manasdas17/LoRa-SmartGarbageCollection/Documentation/Presentation/Smart-Garbage-Collection.pptx

## Smart Garbage Collection

CS 684 - Embedded Systems
Spring 2018

Group members
Manas (163236001)
Sambit (163230013)
Emmey (163230003)

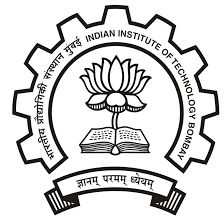
[picture p1: figure]

## Problem Statement

Brief description of the goal of project :
- Placing Sensor based static waste collection garbage bins
- Making it IoT enabled by LoRaWan protocol
- Geo-tagging of bins
- Build an application with an integration to Google Map as background layer
- Indicating different levels of waste to the user

## Requirements :- Hardware

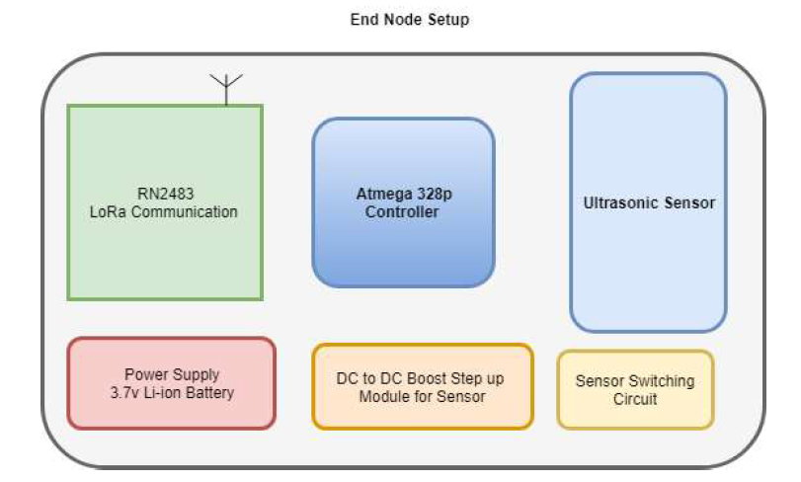
[picture p2: figure]

Software

## Requirements :- Software

Web application having (specific features)
- Waste Level Indicator
- Google Map indication of location of bins
- Framework : javascript, node.js

## Challenges :

- Packaging the hardware in a single PCB
- Making the setup as compact as possible
- Low power design
- Coming up with a web application with specific features
- Problem with Ultrasonic sensor calibration.

## Deliverables

Hardware
- Two no. of sensor nodes with gateway on Rpi
Software
- Web appliation with facility of level indicator of waste and location specifier

## Test Strategies

1. Hardware testing with sensor
2. LoRaWan communication with the sensor node
3. Testing of the sensor node and gateway communication with python script
4. Testing of the whole setup with node, gateway and web application.

## Timeline

1. Circuit Diagram & PCB Design on KiCad (22nd March)
2. Sensor node Setup (29th March)
3. Web application (5th April)
4. Testing & Final delivary(12th April)

## Deliverables-I:Schematic & PCB

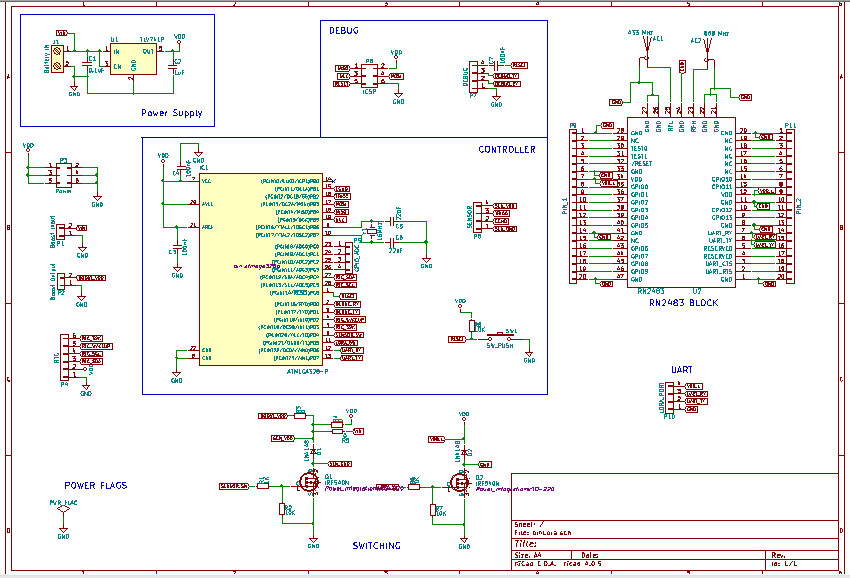
[picture p3: figure]

## Deliverables-I:Schematic & PCB

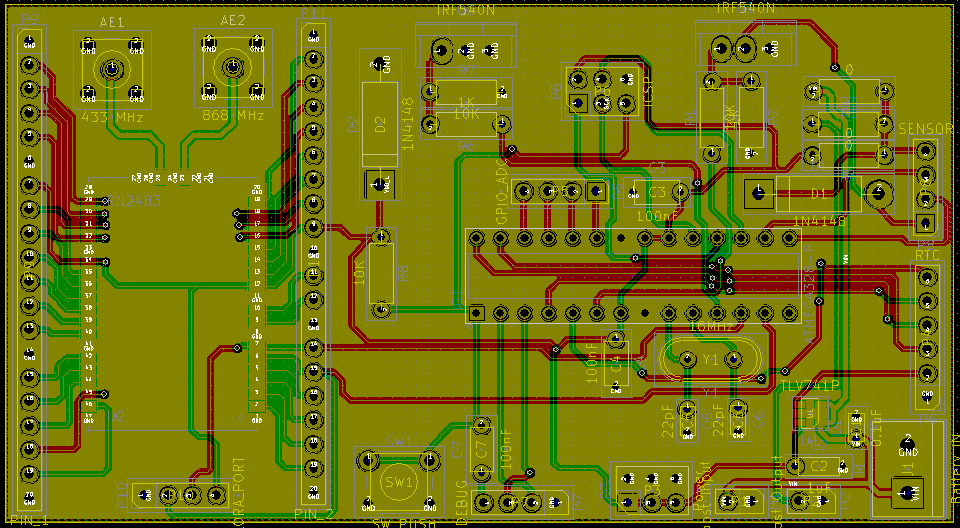
[picture p4: figure]

## Deliverables-II: Node setup

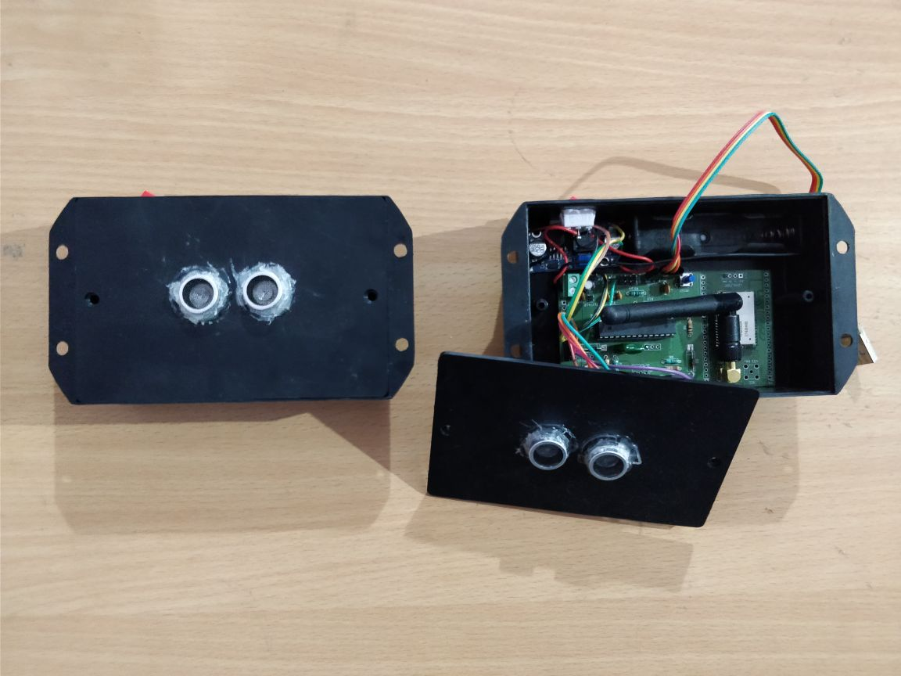
[picture p5: figure]

## Deliverables-III: Dashboard

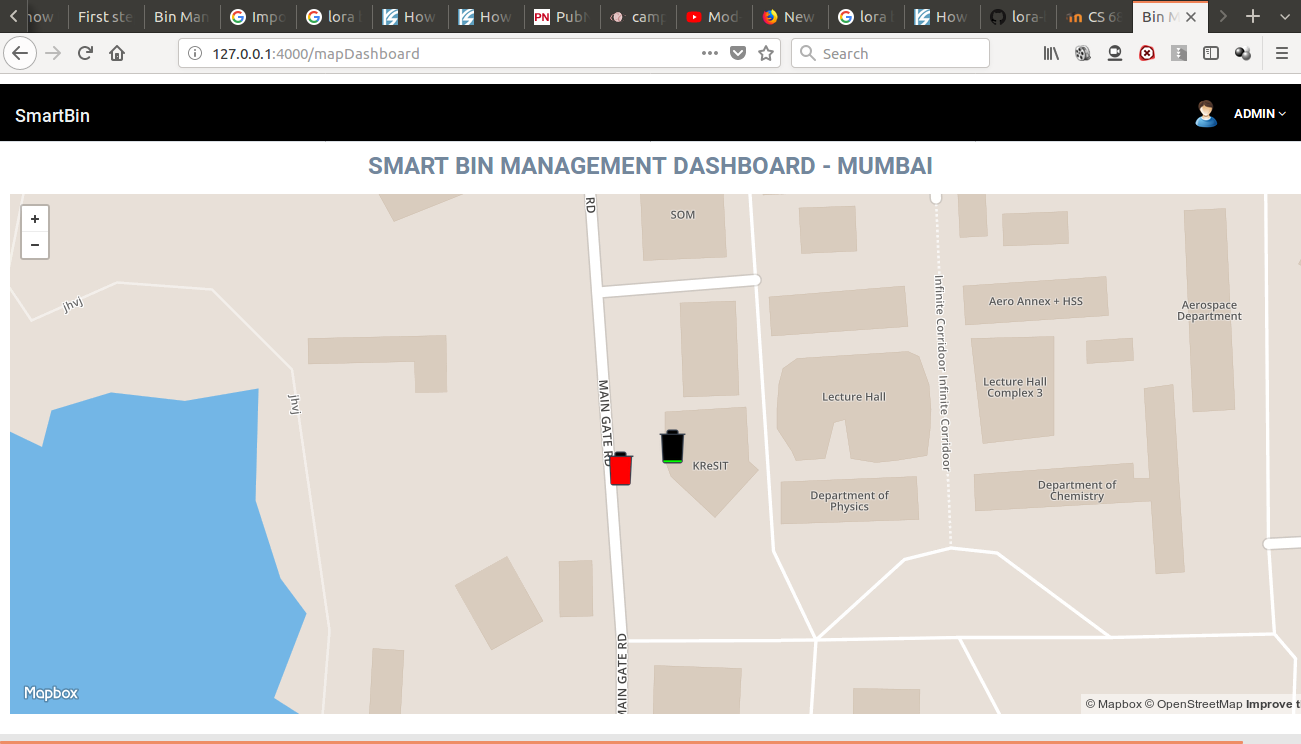
[picture p6: figure]

## Deliverables-IV: Testing

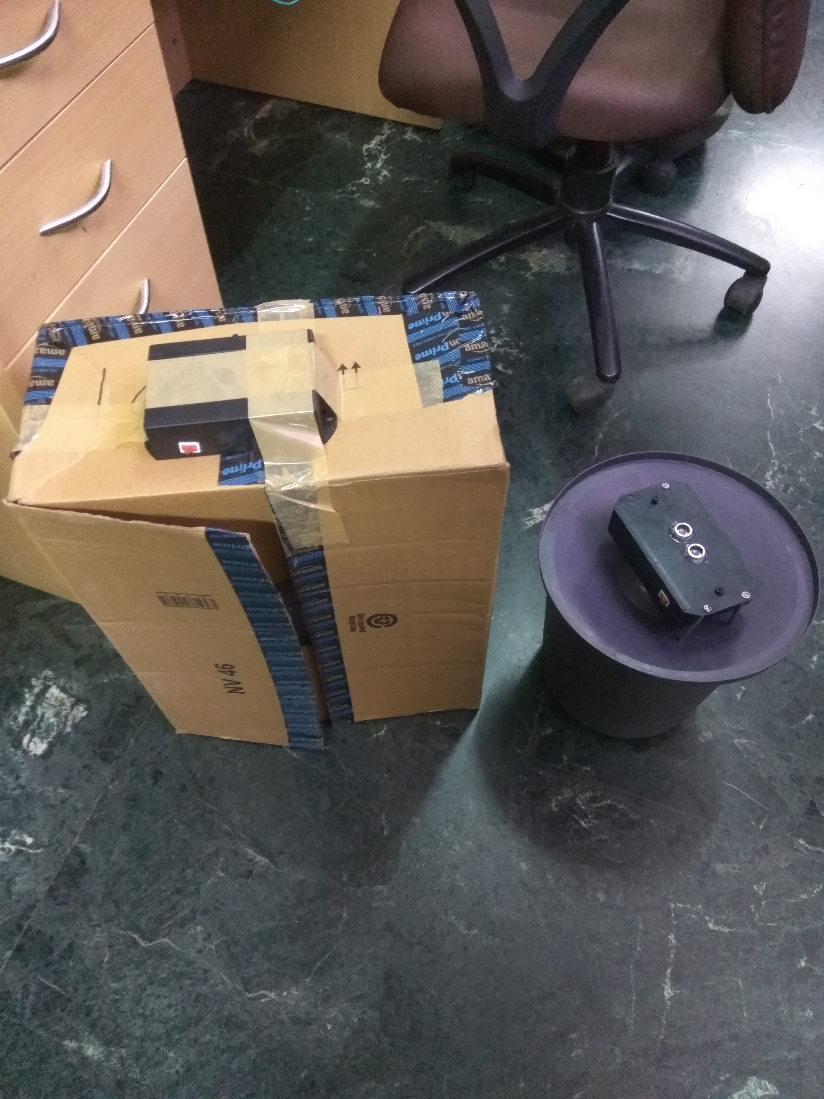
[picture p7: figure]
