manasdas17/LoRa-SmartGarbageCollection/Documentation/Report/CS-684-2018-Report.pdf

# CS-684-2018 Final Report Smart Garbage Collection Team Smart Clean Team Code - 03

### Manas Das(163236001) Sambit Senapati(163230013) Emmey Teja(163230003)

### Under Guidance of Prof. Kavi Arya

TA

### Saurav Shandilya

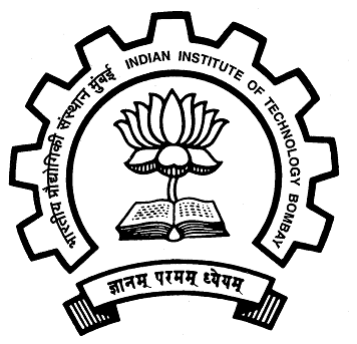
[picture p8: figure]

### Computer Science & Engineering, IIT Bombay April 29, 2018

2

# Contents

1 Introduction | 2
2 Problem Statement | 4
3 Requirements | 6
4 System Design | 8
5 Working of the system & Test Results | 12
6 Discussion of the system | 17
7 Future work | 18
8 Conclusion | 19
C | Arduino code for Lora communication & Waste detection | 29

1

# Chapter 1

# Introduction

Deploying smart garbage bins for real time waste management system is one of the key applications of a smart city system. Municipal authorities need an efficient way to clear the trash from all public places before it becomes a mess. And this needs to be achieved with the minimum overhead of cost and impact to the city dwellers. LoRaWAN is one of the earlier LPWAN technologies that envisages a city-wide network for keeping track of public infrastructure assets. Once fitted with a BLS(Bin Level Sensing) device on a trash can, LoRaWAN allows the city authorities to keep a tab on the bins via wireless connectivity. LoRaWAN[5] does suffer from some limitations, such as extremely low data rates, higher collision and deteriorated network performance with increasing number of nodes and inability to perform over the air updates to the device. Like every emerging technology, it is also going through an evolutionary phase and is also getting a healthy competition from some of the other emerging standards such as NB-IoT and Weightless. However, at the current state, this technology is well suited for non-mission critical[2] applications, and tracking garbage bins is one such use case.The overall architecture of implementation will be as shown in fig 1.1

2

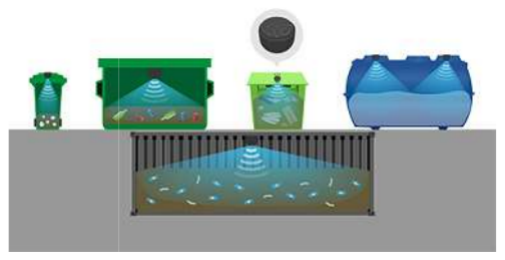
[picture p9: figure]

Figure 1.1: Overall Implementation

3

# Chapter 2

# Problem Statement

## 2.1 Goal to achieve

The aim is to implement smart waste management by means of LoRaWAN protocol. LoRaWAN[4] provides long range wireless communication with ultra-low power consumption that enables very long battery life. Our task is to build a smart garbage bin[1] with level indicator to be implemented on Atmega328p i.e. compatible with Arduino IDE as sensor node and a javascript based web application with Google map integrated into it which will indicate location of the bin.This solution is ideally suited for waste pickup and management companies, who can optimize their logistics resources while reducing collection costs. The overall implementation looks as in fig 2.1

4

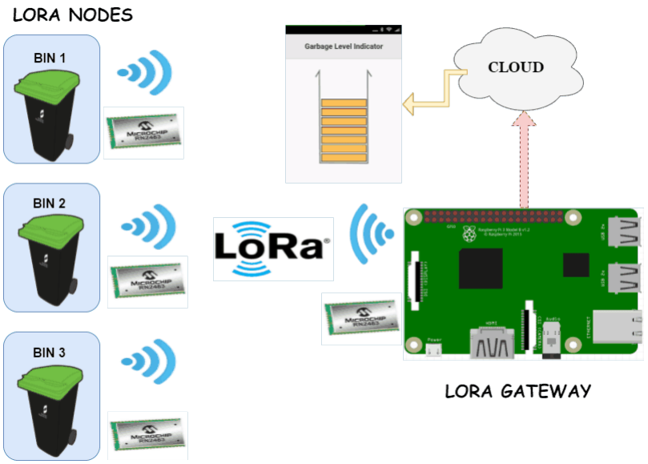
[picture p10: figure]

Figure 2.1: Overall Implementation

5

# Chapter 3

# Requirements

## 3.1 Functional Requirements

1. Node – This is the BLS device fitted in the garbage bin. It has an ultrasonic sensor to sense the garbage level inside the bin and a LoRa module (Microchip RN2483) as the communication interface. The node hardware is based on Atmega328p.
2. Ultrasonic sensor to detect the solid wastes in the bin
3. Level indicator detection on the node setup and displaying the same on the dashboard.
4. Gateway – This is used as an external gateway, which aggregates the data from the nodes and pushes it to cloud. The gateway connects to the nodes using LoRa. The gateway is built upon Raspberry Pi/User Laptop and it is also interfaced with RN2483 for receiving the data from nodes over LoRa physical layer.
5. WEB / Mobile UI App – Web app shows the all the bins in the city on google map and current level of the bins live on the dashboard with user authentication.

## 3.2 Non-functional Requirements

1. Database integration with dashboard as the all the realtime data can be stored on cloud platforms like PubNub.com.

6

2. Real-time Google map tracker

## 3.3 Hardware Requirements

1. Compact circuit design of Sensor Node with Atmega328p, Lora Module[3], Ultrasonic sensor, sensor switching circuit and DC to DC booster module.
2. Coming up with a compact PCB design so that all the sensors and communicating modules can be fitted and setup can be used as robust standalone module.

## 3.4 Software Requirements

1. Developing an Arduino code for proper functioning of sensor node with Lora module with the facility of level indicator for waste level.
2. Python code to initiate lora environment and taking data from sensor node to dashboard.
3. Developing a web application for sensor data visualization and indicating the location of the bin on Google map.

7

# Chapter 4

# System Design

## 4.1 Overall System Architecture

The overall implementation is described as in fig.2.1

## 4.2 Hardware Architecture

Basic architecture of sensor node is as described in fig. 4.1
Each sensor node is made to be built on a compact PCB with following components mounted on it, such as :
1. Armega328p
2. Ultrasonic sensor
3. Lora Module i.e. RN2483
4. Low-dropout or LDO, booster module and all the necessary components mounted on it

The circuit design looks as in fig 4.2
PCB design of the sensor is as described in fig 4.3 The packaged sensor node looks as shown in fig 4.4

8

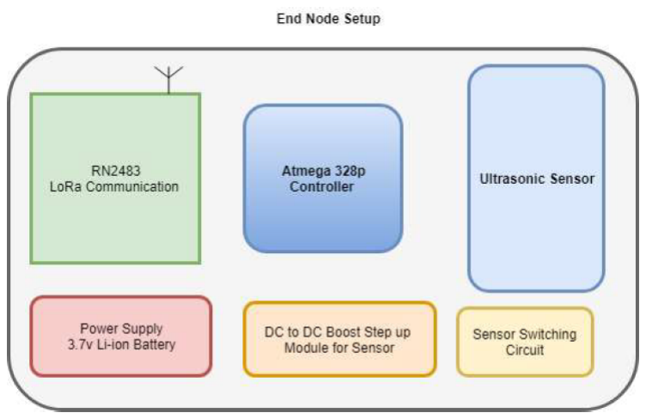
[picture p11: figure]

Figure 4.1: Sensor node architecture

9

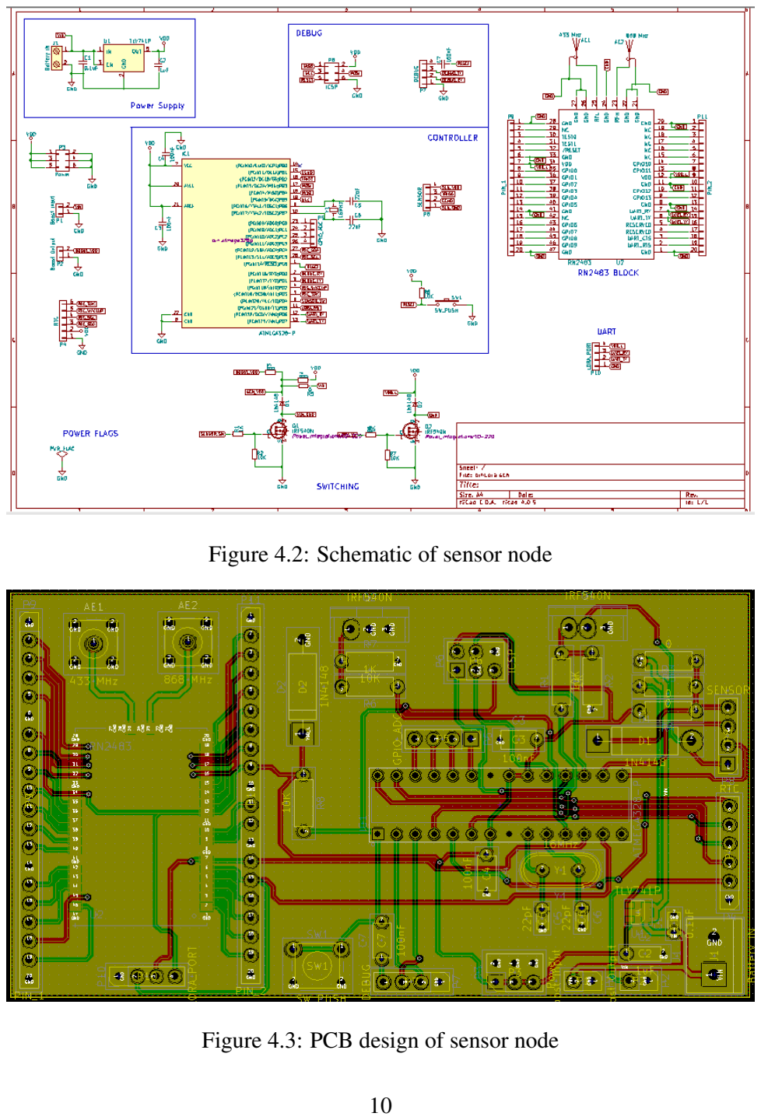
[picture p12: page 11]

Figure 4.2: Schematic of sensor node

Figure 4.3: PCB design of sensor node

10


Figure 4.4: Overall node setup

11

# Chapter 5

# Working of the system & Test Results

The whole setup was built with two sensor nodes and a gateway.
The gateway on linux machine with lora module attached is as shown in fig 5.1
Sensor node setup as packaged is shown in fig 5.2
Testing setup of two sensor nodes with waste bins are done as shown in fig 5.3 Sensor data from the nodes and its visualization on dashboard is shown as verification in fig 5.4

12

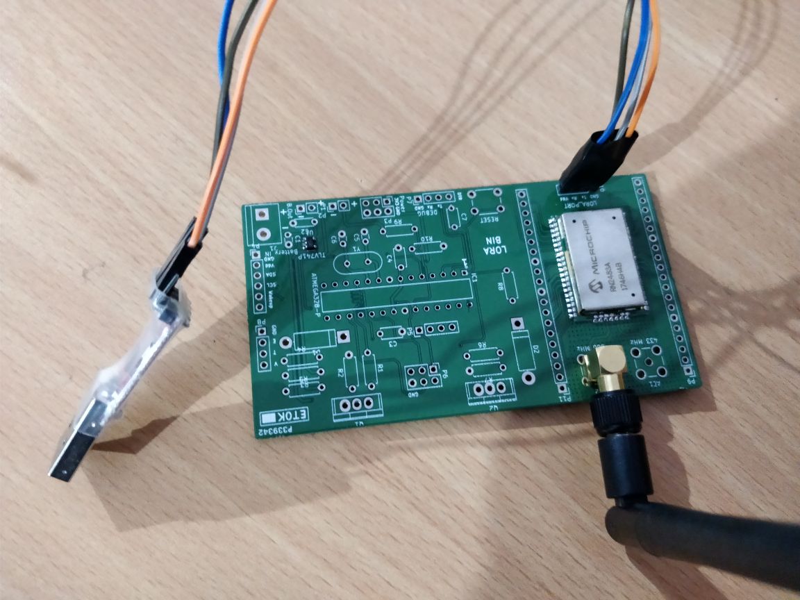
[picture p13: figure]

Figure 5.1: Gateway Lora module seup

13

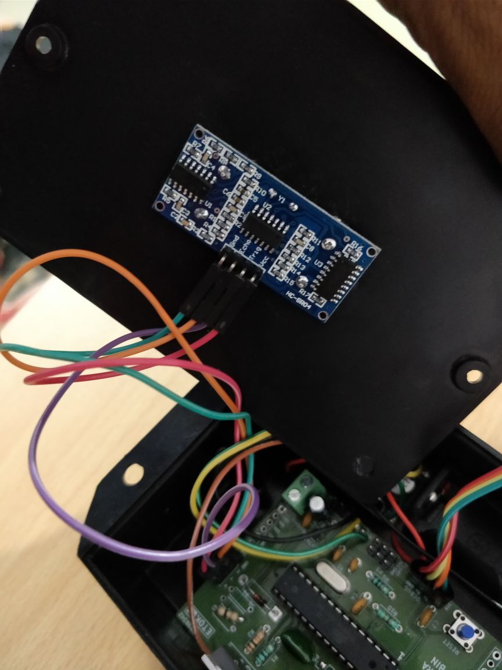
[picture p14: figure]

Figure 5.2: Sensor node

14


Figure 5.3: Realtime Testing of sensor nodes

15


Figure 5.4: Dashboard with Google map & level indicator

16

# Chapter 6

# Discussion of the system

- The setup is working accordingly as expected i.e. showing the waste levels and specifying the location on dashboard.But the levels indicated by the ultrasonic sensor is not quite adaptive to different sizes of the bins i.e. bins of varying length.
- The sensor node built is quite compact in form and robust with proper power management facilities.

17

# Chapter 7

# Future work

- The major issue with this setup is the ultrasonic sensor isn’t adaptive i.e. it doesn’t detect the level of waste in the bin properly for bins of different sizes.
- On next stage of implementation, the product can suffice environmental sensors (Capturing Moisture, Bin movement using GPS / Motion Sensors) and sensor to detect the tilt of the BIN Top Door.
- Maps can be improved showing the route of the filled bins.

18

# Chapter 8

# Conclusion

The overall system with LoRaWAN protocol for smart garbage collection was implemented successfully and initially the PoC was tested for its working.But as the PoC was bulky so came up with a much robust, compact model which is more portable and easy to install in variuos environment conditions.And the whole system was tested with two nodes fitted to different waste bins and dashboard hosted on linux machine.The whole of the setup is worked pretty well and the previous data instances being stored on PubNub.com cloud pltaform.

## Appendices

### A Python code of lora environment initialization

Python Code .1 mclora.py

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

4
5 ’ ’ ’
****************************************************************************************
6 | C l a s s Name | : | MCLoRa
7 | D e s c r i p t i o n | : | Ha n dle LoRa E v e nt s

19

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

40

20

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

21

72 | d a t a = d a t a [ 1 ]
73 | r e t u r n d a t a

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

22

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

109
110 | #End o f t h e S c r i p t
111 | ##******** **************** ***************** **************** **************** **************** ************

### B Python code for data receive on gateway

Python Code .2 binServer.py

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

17
18 TIME ZONE = ” A si a / K ol k at a ”

19
20 | bi nMa p pi n g = {
21 | ”25046B” : 1 ,
22 | ”25046A” : 2
23 | }
| 23

24
25 p n c o n fi g = P NC o n fi g u r ati o n ( )

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

29
30 pubnub = PubNub ( p n c o n fi g )

31
32 | # System V a r i a b l e s
33 | p o r t = ” ”
34 | lo raM = ” ”

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

53

24

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

68
69 | d e f me s sa ge ( s e l f , pubnub , me s sa ge ) :
70 | p r i n t me s sa ge

71

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

104
105 | r e t u r n s c a l e d

106

107 | ’ ’ ’
| ****************************************************************************************
| 26

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

135

| | | 27

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

138

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

166
167 | p r i n t ( ” Bin Management S t a r t e d . . . \ n ” )

168
169 | w hil e T r ue :

28

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

174

175
176 | #End o f t h e S c r i p t
177 | ##******** **************** ***************** **************** **************** **************** ************##

### C Arduino code for Lora communication & Waste detection

Arduino Code .1 smartBin withSleep.ino

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

4
5 | / / LoRa S e r i a l
6 | S o f t w a r e S e r i a l S e r i a l 1 ( 7 , 6 ) ; / / RX, TX

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

22
23 | v oi d s y s t e m I n i t ( ) {
24 | / / S e n s o r I n i t
| 29

25 | pinMode ( Sensor VDD , OUTPUT ) ;
26 | pinMode ( t r i g P i n , OUTPUT ) ; / / S e t s t h e t r i g P i n a s an
| O ut p ut
27 | pinMode ( ec h oPi n , INPUT ) ; / / S e t s t h e e c h o Pi n a s an
| I n p u t

28
29 | / / LoRa I n i t
30 | pinMode ( LoRa VDD , OUTPUT ) ;
31 | S e r i a l 1 . b e gi n ( 5 7 6 0 0 ) ;

32

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

44
45 i n t sl e e p C o u nt = 0 ;

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

58
59 | v oi d l o r a R e s e t ( )
| 30

60 | {
61 | d i g i t a l W r i t e ( LoRa VDD , LOW) ;
62 | d e l a y ( 2 5 0 ) ;
63 | d i g i t a l W r i t e ( LoRa VDD , HIGH ) ;
64 | d e l a y ( 2 5 0 ) ;
65 | }

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

0 . 0 3 4 / 2 ;

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

135
136 d e l a y ( 5 0 0 ) ;

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

145
146 | d e l a y ( 3 0 0 0 ) ;
147 | }

33

# Bibliography

[1] Abhay Shankar Bharadwaj; Rainer Rego; Anirban Chowdhury. IoT based solid waste management system: A conceptual approach with an architectural solution as a smart city application. IEEE Annual India Conference (INDICON), 2016.
[2] Mehrdad Babazadeh; Sokratis Kartakis; Julie A McCann. Highly-distributed sensor processing using IoT for critical infrastructure monitoring . Asia-Pacific Signal and Information Processing Association Annual Summit and Conference (APSIPA ASC), 2017.
[3] Mirochip. http://www.microchip.com/wwwproducts/en/RN2483. 2016.
[4] Alexandru Lavric; Valentin Popa. A LoRaWAN: Long range wide area networks study. International Conference on Electromechanical and Power Systems (SIELMEN), 2017.
[5] Steffen Thielemans; Maite Bezunartea; Kris Steenhaut. Establishing transparent IPv6 communication on LoRa based low power wide area networks (LPWANS). Wireless Telecommunications Symposium (WTS), 2017.

34
