manasdas17/LoRa-SmartGarbageCollection/Code/pcbDesign/binLora.pdf

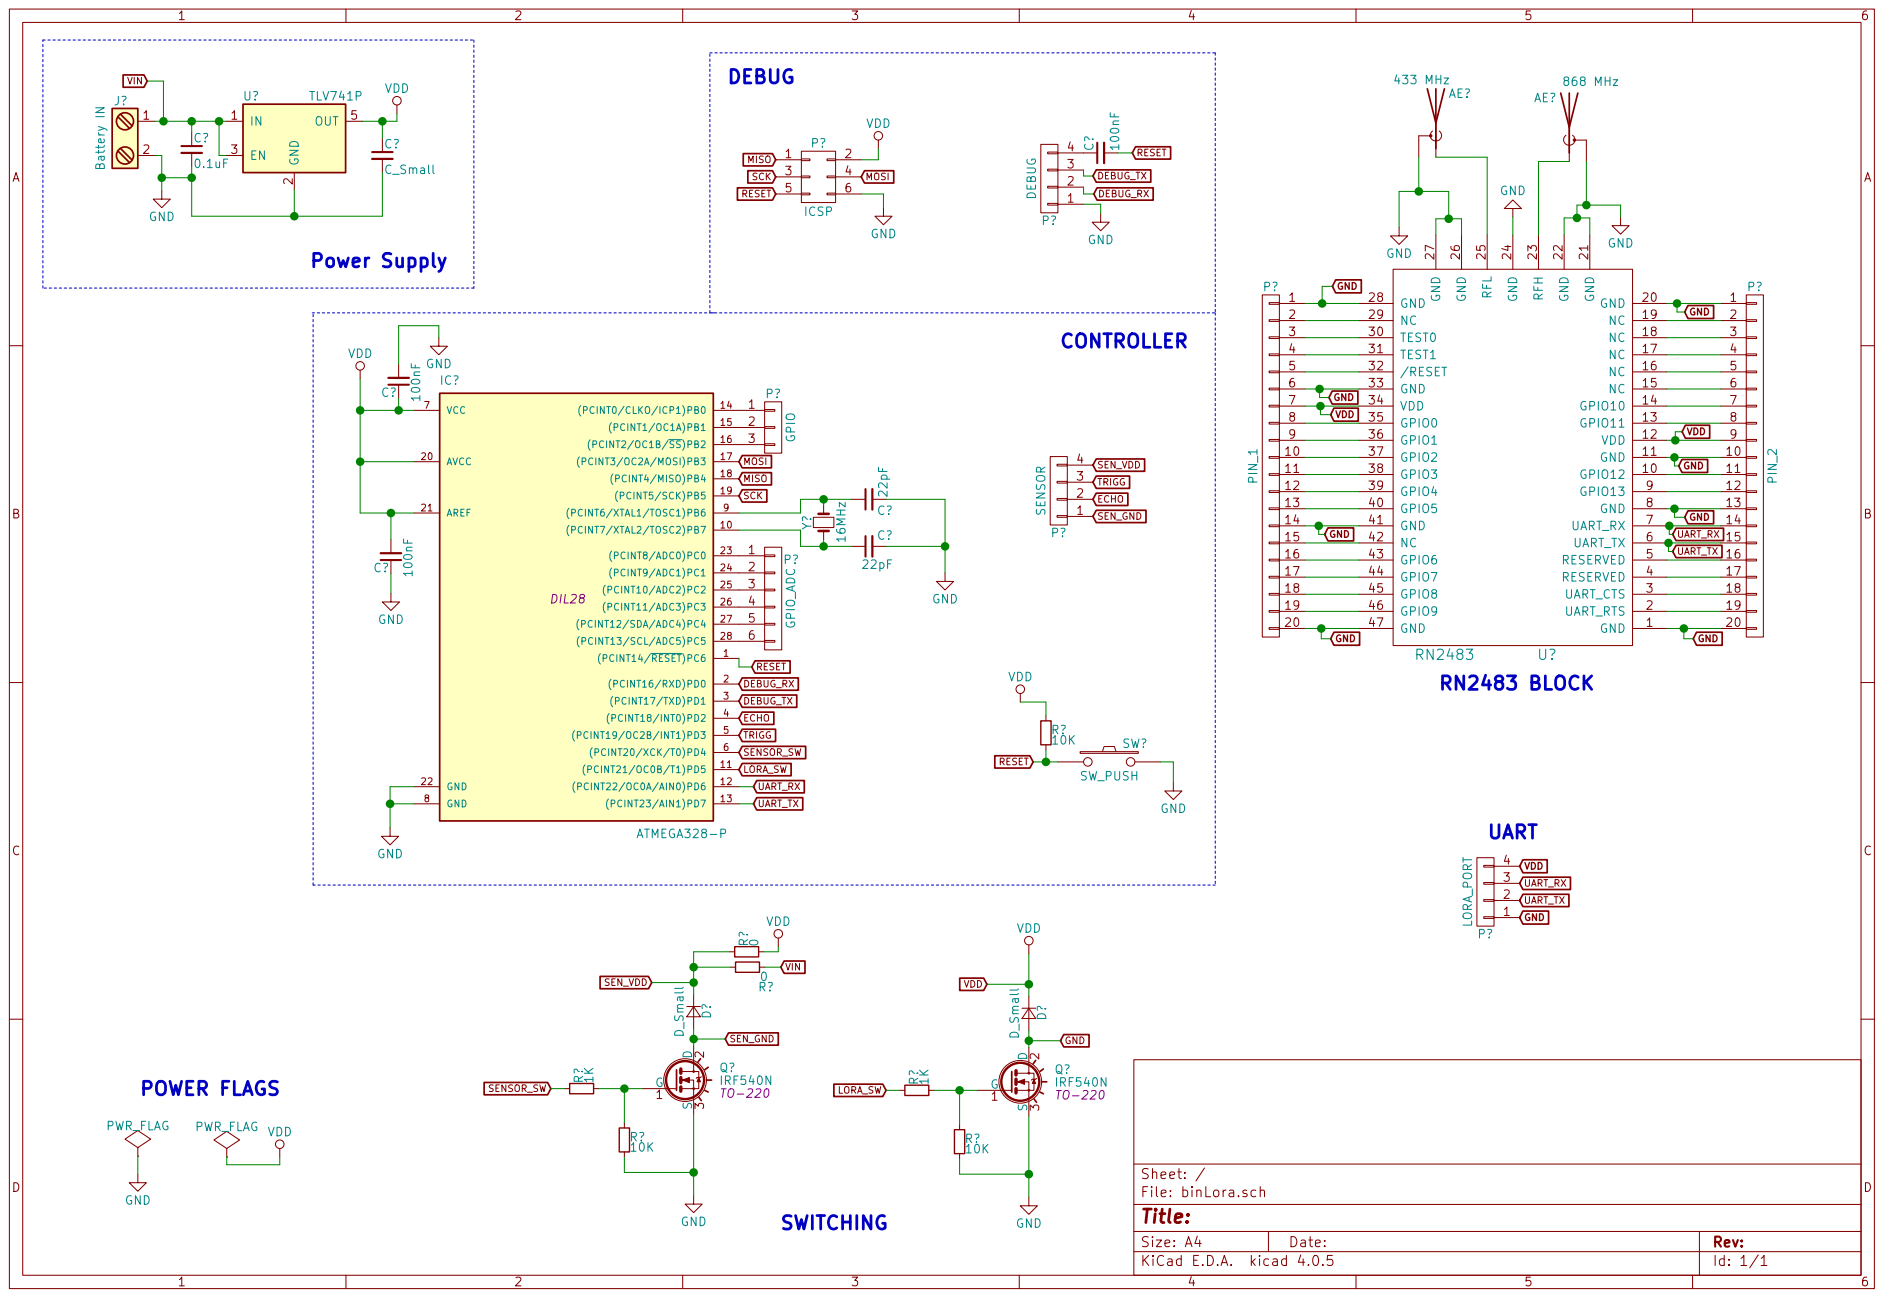
[picture p15: page 1]

DEBUG

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
Id: 1/1 Title: File: binLora.sch Sheet: /
