manasdas17/LoRa-SmartGarbageCollection/Code/pcbDesign/binLora.kicad_pcb

## KiCad design Code/pcbDesign/binLora.kicad_pcb (2018-05-28)

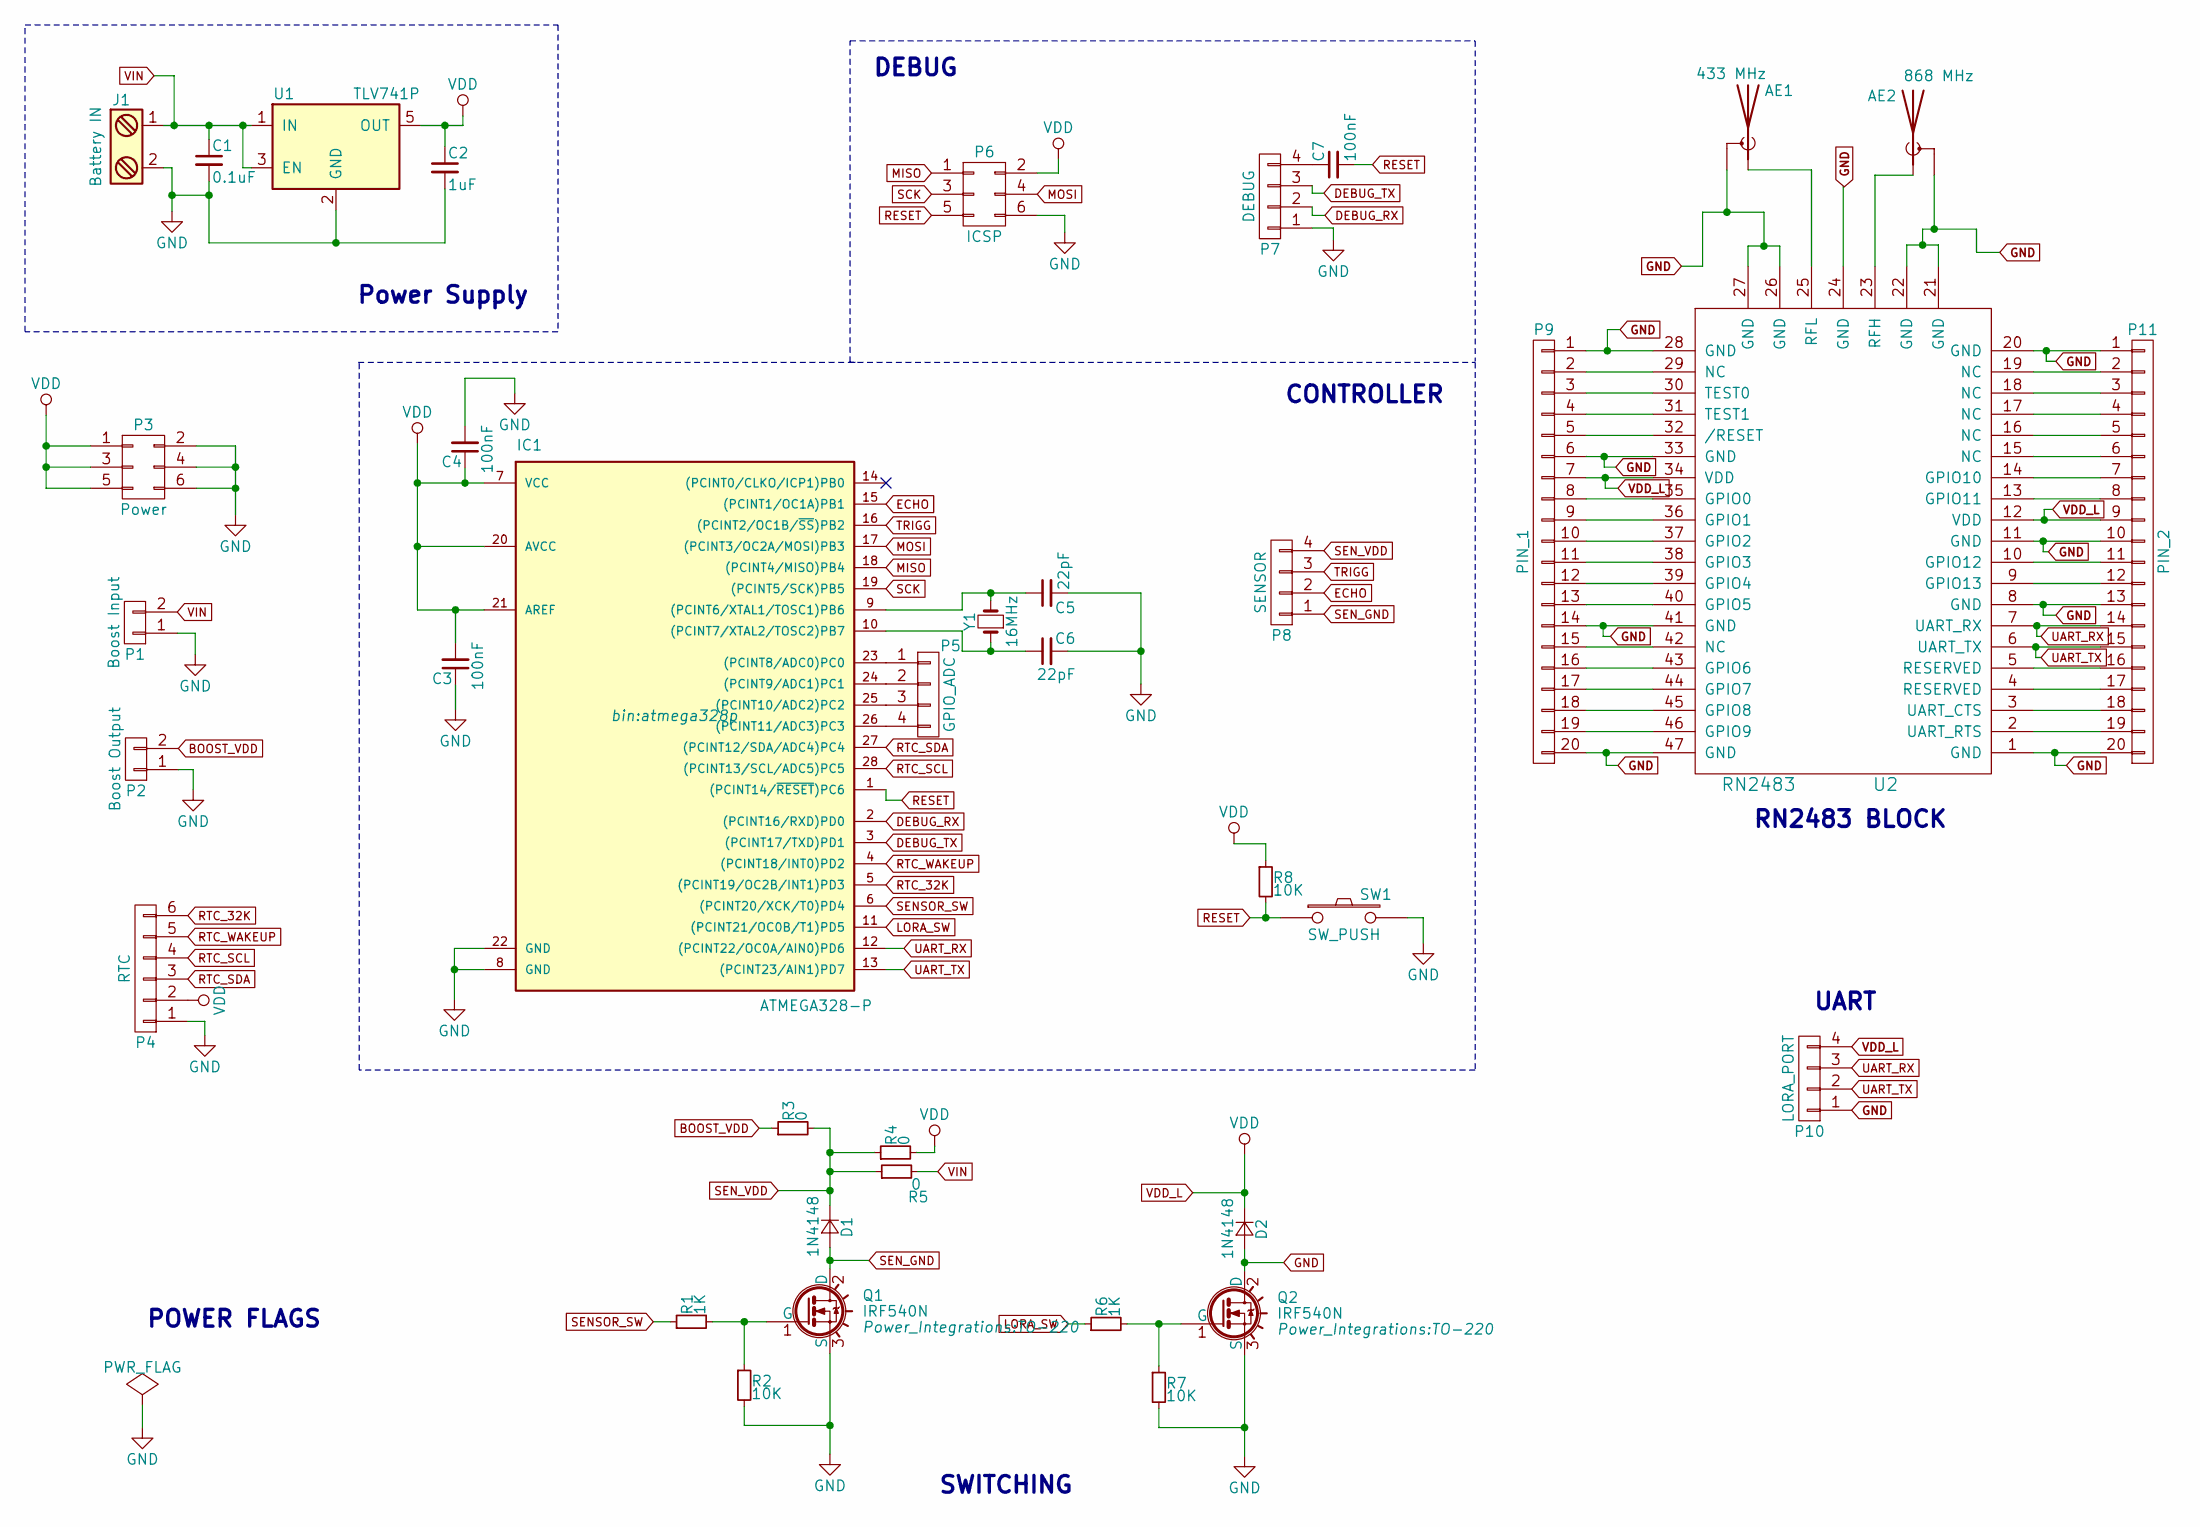
[picture p16: schematic binLora.sch]

Parts:
AE1: 433 MHz; SMA_THT_Jack_Straight
AE2: 868 MHz; SMA_THT_Jack_Straight
C1: 0.1uF; C_Disc_D3.0mm_W1.6mm_P2.50mm
C2: 1uF; C_Disc_D4.3mm_W1.9mm_P5.00mm
C3, C4, C7: 100nF; C_Disc_D4.7mm_W2.5mm_P5.00mm
C5, C6: 22pF; C_Disc_D3.0mm_W1.6mm_P2.50mm
D1, D2: 1N4148; D_5W_P12.70mm_Horizontal
IC1: ATMEGA328-P; atmega328p
J1: Battery IN; TerminalBlock_bornier-2_P5.08mm
P1: Boost Input; Pin_Header_Straight_1x02_Pitch2.54mm
P2: Boost Output; Pin_Header_Straight_1x02_Pitch2.54mm
P3: Power; Pin_Header_Straight_2x03_Pitch2.54mm
P4: RTC; Pin_Header_Straight_1x06_Pitch2.54mm
P5: GPIO_ADC; Pin_Header_Straight_1x04_Pitch2.54mm
P6: ICSP; Pin_Header_Straight_2x03_Pitch2.54mm
P7: DEBUG; Pin_Header_Straight_1x04_Pitch2.54mm
P8: SENSOR; Pin_Header_Straight_1x04_Pitch2.54mm
P9: PIN_1; Pin_Header_Straight_1x20_Pitch2.54mm
P10: LORA_PORT; Pin_Header_Straight_1x04_Pitch2.54mm
P11: PIN_2; Pin_Header_Straight_1x20_Pitch2.54mm
Q1, Q2: IRF540N; TO-220
R1, R6: 1K; R_Axial_DIN0207_L6.3mm_D2.5mm_P7.62mm_Horizontal
R2, R7, R8: 10K; R_Axial_DIN0207_L6.3mm_D2.5mm_P7.62mm_Horizontal
R3, R4, R5: 0; R_Axial_DIN0207_L6.3mm_D2.5mm_P7.62mm_Horizontal
SW1: SW_PUSH; SW_PUSH_6mm
U1: TLV741P; SOT-23-5
U2: RN2483
Y1: 16MHz; Crystal_HC49-U_Vertical

Connections:
BOOST_VDD: P2.2, R3.1
DEBUG_RX: IC1.2 ((PCINT16/RXD)PD0), P7.2
DEBUG_TX: IC1.3 ((PCINT17/TXD)PD1), P7.3
ECHO: IC1.15 ((PCINT1/OC1A)PB1), P8.2
GND: AE1.2 (Shield), AE2.2 (Shield), C1.2, C2.2, C3.1, C4.2, C5.2, C6.2, D2.2 (A), IC1.8 (GND), IC1.22 (GND), J1.2, P1.1, P2.1, P3.2, P3.4, P3.6, P4.1, P6.6, P7.1, P9.1, P9.6, P9.14, P9.20, P10.1, P11.1, P11.10, P11.13, P11.20, Q1.3 (S), Q2.2 (D), Q2.3 (S), R2.2, R7.2, SW1.2, U1.2 (GND), U2.1 (GND), U2.8 (GND), U2.11 (GND), U2.20 (GND), U2.21 (GND), U2.22 (GND), U2.24 (GND), U2.26 (GND), U2.27 (GND), U2.28 (GND), U2.33 (GND), U2.41 (GND), U2.47 (GND)
LORA_SW: IC1.11 ((PCINT21/OC0B/T1)PD5), R6.1
MISO: IC1.18 ((PCINT4/MISO)PB4), P6.1
MOSI: IC1.17 ((PCINT3/OC2A/MOSI)PB3), P6.4
unnamed: AE1.1 (A), U2.25 (RFL)
unnamed: AE2.1 (A), U2.23 (RFH)
unnamed: C5.1, IC1.9 ((PCINT6/XTAL1/TOSC1)PB6), Y1.2
unnamed: C6.1, IC1.10 ((PCINT7/XTAL2/TOSC2)PB7), Y1.1
unnamed: C7.1, P7.4
unnamed: IC1.23 ((PCINT8/ADC0)PC0), P5.1
unnamed: IC1.24 ((PCINT9/ADC1)PC1), P5.2
unnamed: IC1.25 ((PCINT10/ADC2)PC2), P5.3
unnamed: IC1.26 ((PCINT11/ADC3)PC3), P5.4
unnamed: P9.2, U2.29 (NC)
unnamed: P9.3, U2.30 (TEST0)
unnamed: P9.4, U2.31 (TEST1)
unnamed: P9.5, U2.32 (/RESET)
unnamed: P9.8, U2.35 (GPIO0)
unnamed: P9.9, U2.36 (GPIO1)
unnamed: P9.10, U2.37 (GPIO2)
unnamed: P9.11, U2.38 (GPIO3)
unnamed: P9.12, U2.39 (GPIO4)
unnamed: P9.13, U2.40 (GPIO5)
unnamed: P9.15, U2.42 (NC)
unnamed: P9.16, U2.43 (GPIO6)
unnamed: P9.17, U2.44 (GPIO7)
unnamed: P9.18, U2.45 (GPIO8)
unnamed: P9.19, U2.46 (GPIO9)
unnamed: P11.2, U2.19 (NC)
unnamed: P11.3, U2.18 (NC)
unnamed: P11.4, U2.17 (NC)
unnamed: P11.5, U2.16 (NC)
unnamed: P11.6, U2.15 (NC)
unnamed: P11.7, U2.14 (GPIO10)
unnamed: P11.8, U2.13 (GPIO11)
unnamed: P11.11, U2.10 (GPIO12)
unnamed: P11.12, U2.9 (GPIO13)
unnamed: P11.16, U2.5 (RESERVED)
unnamed: P11.17, U2.4 (RESERVED)
unnamed: P11.18, U2.3 (UART_CTS)
unnamed: P11.19, U2.2 (UART_RTS)
unnamed: Q1.1 (G), R1.2, R2.1
unnamed: Q2.1 (G), R6.2, R7.1
RESET: C7.2, IC1.1 ((PCINT14/~RESET~)PC6), P6.5, R8.2, SW1.1
RTC_32K: IC1.5 ((PCINT19/OC2B/INT1)PD3), P4.6
RTC_SCL: IC1.28 ((PCINT13/SCL/ADC5)PC5), P4.4
RTC_SDA: IC1.27 ((PCINT12/SDA/ADC4)PC4), P4.3
RTC_WAKEUP: IC1.4 ((PCINT18/INT0)PD2), P4.5
SCK: IC1.19 ((PCINT5/SCK)PB5), P6.3
SENSOR_SW: IC1.6 ((PCINT20/XCK/T0)PD4), R1.1
SEN_GND: D1.2 (A), P8.1, Q1.2 (D)
SEN_VDD: D1.1 (K), P8.4, R3.2, R4.1, R5.1
TRIGG: IC1.16 ((PCINT2/OC1B/~SS~)PB2), P8.3
UART_RX: IC1.12 ((PCINT22/OC0A/AIN0)PD6), P10.3, P11.14, U2.7 (UART_RX)
UART_TX: IC1.13 ((PCINT23/AIN1)PD7), P10.2, P11.15, U2.6 (UART_TX)
VDD_L: C2.1, C3.2, C4.1, D2.1 (K), IC1.7 (VCC), IC1.20 (AVCC), IC1.21 (AREF), P3.1, P3.3, P3.5, P4.2, P6.2, P9.7, P10.4, P11.9, R4.2, R8.1, U1.5 (OUT), U2.12 (VDD), U2.34 (VDD)
VIN: C1.1, J1.1, P1.2, R5.2, U1.1 (IN), U1.3 (EN)

Notes on the sheet:
RN2483 BLOCK
UART
Power Supply
DEBUG
CONTROLLER
SWITCHING
POWER FLAGS

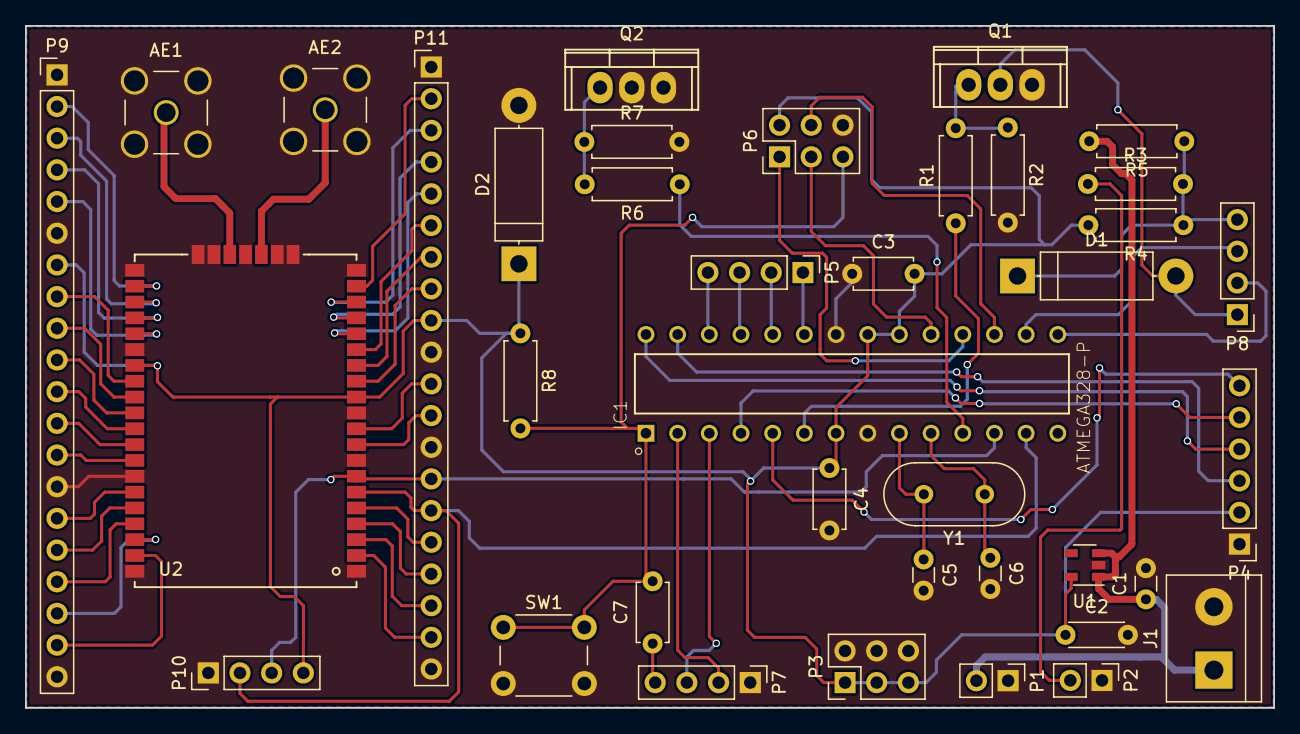
[picture p17: board binLora.kicad_pcb from above]

Board: 2 copper layers, 100.1 x 54.7 mm, 38 parts (0 on the bottom side), 61 nets.
